KnightHill/wah-hardware/hardware/Terrarium-PedalPCB.pdf

# Terrarium Platform

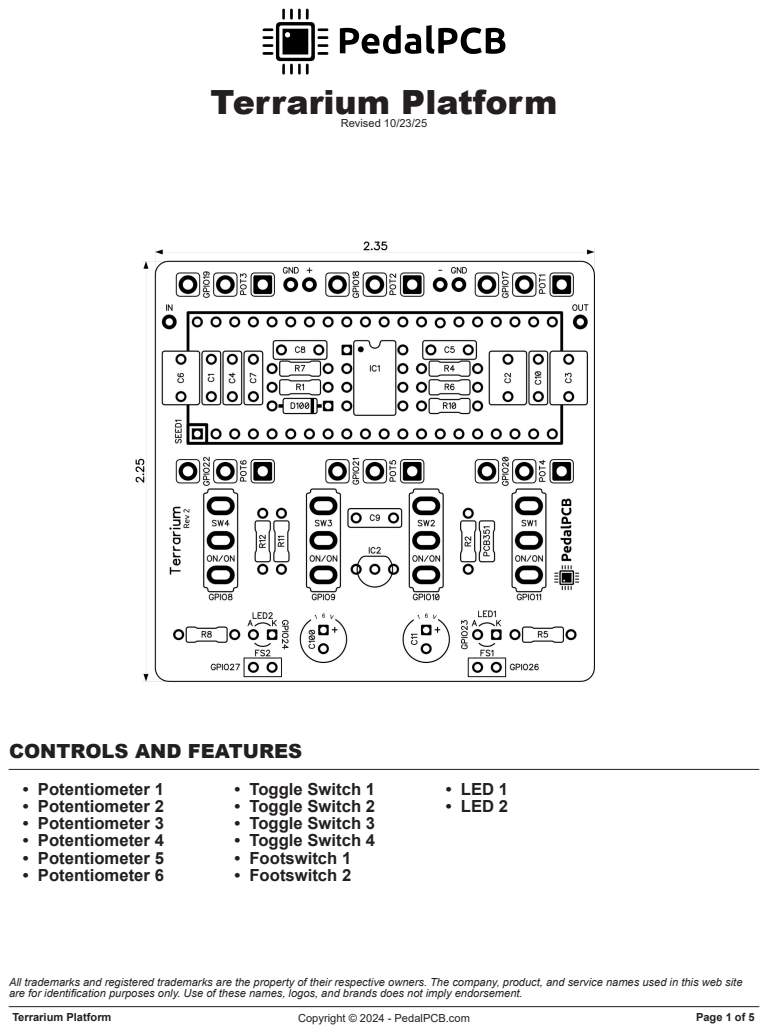
[picture p1: page 1]
Terrarium Platform; Copyright © 2024 - PedalPCB.com; Page 1 of 5; Revised 10/23/25; • Potentiometer 1 • Potentiometer 2 • Potentiometer 3 • Potentiometer 4 • Potentiometer 5 • Potentiometer 6; • Toggle Switch 1 • Toggle Switch 2 • Toggle Switch 3 • Toggle Switch 4 • Footswitch 1 • Footswitch 2; • LED 1 • LED 2

CONTROLS AND FEATURES

All trademarks and registered trademarks are the property of their respective owners. The company, product, and service names used in this web site
are for identification purposes only. Use of these names, logos, and brands does not imply endorsement.

Terrarium Platform | Copyright © 2024 - PedalPCB.com | Page 2 of 5

## Terrarium Platform

Parts List (Page 1 of 1)
LOCATION | VALUE | TYPE | NOTES
R1 | 1M | Resistor, 1/4W
R2 | 1M | Resistor, 1/4W
R4 | 100R | Resistor, 1/4W
R5 | 1K | Resistor, 1/4W
R6 | 100K | Resistor, 1/4W
R7 | 1K | Resistor, 1/4W
R8 | 1K | Resistor, 1/4W
R10 | 3K3 | Resistor, 1/4W
R11 | 100K | Resistor, 1/4W
R12 | 100K | Resistor, 1/4W
C1 | 100p | Ceramic capacitor
C2 | 1u | MLCC capacitor, 7.2 x 2.5mm
C3 | 1u | MLCC capacitor, 7.2 x 2.5mm
C4 | 100n | Film capacitor, 7.2 x 2.5mm
C5 | 100n | Film capacitor, 7.2 x 2.5mm
C6 | 1u | MLCC capacitor, 7.2 x 2.5mm
C7 | 1n | Film capacitor, 7.2 x 2.5mm
C8 | 100n | Film capacitor, 7.2 x 2.5mm
C9 | 100n | Film capacitor, 7.2 x 2.5mm
C10 | 2n2 | Film capacitor, 7.2 x 2.5mm
C11 | 100u | Electrolytic capacitor, 5mm
C100 | 100u | Electrolytic capacitor, 5mm
D100 | 1N5817 | Schottky diode, DO-41
IC1 | TL072 | Dual op-amp, DIP8
IC2 | L78L05 | Linear voltage regulator, 5V
SEED1 | Electro-Smith Daisy Seed Module
POT1 | B10K | 16mm right-angle PCB mount pot
POT2 | B10K | 16mm right-angle PCB mount pot
POT3 | B10K | 16mm right-angle PCB mount pot
POT4 | B10K | 16mm right-angle PCB mount pot
POT5 | B10K | 16mm right-angle PCB mount pot
POT6 | B10K | 16mm right-angle PCB mount pot
SW1 | SPDT ON/ON | Toggle switch, SPDT | 2-position (ON/ON)
SW2 | SPDT ON/ON | Toggle switch, SPDT | 2-position (ON/ON)
SW3 | SPDT ON/ON | Toggle switch, SPDT | 2-position (ON/ON)
SW4 | SPDT ON/ON | Toggle switch, SPDT | 2-position (ON/ON)
FS1 | SPST | Foot switch, SPST | Momentary SPST
FS2 | SPST | Foot switch, SPST | Momentary SPST
PINHEADER | 20-pin Female 2.54mm Pinheader | Quantity: 2

# Terrarium Platform

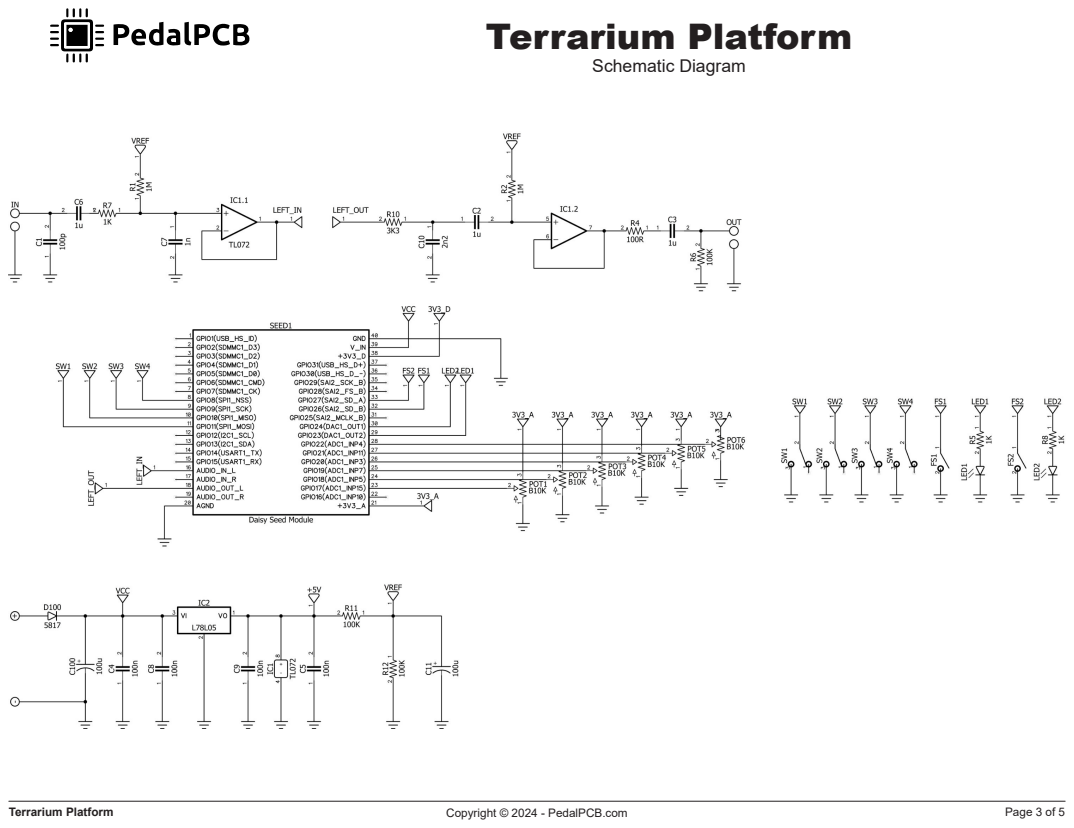
[picture p2: page 3]
Terrarium Platform; Copyright © 2024 - PedalPCB.com; Page 3 of 5; Schematic Diagram

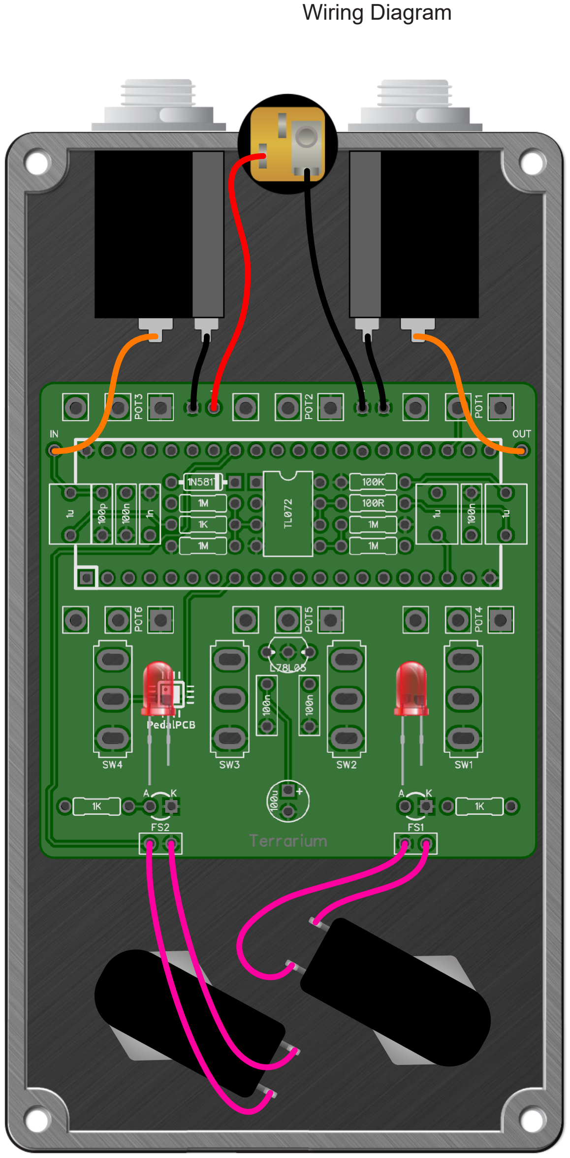
[picture p3: figure]
Wiring Diagram

Terrarium Platform | Copyright © 2024 - PedalPCB.com | Page 4 of 5

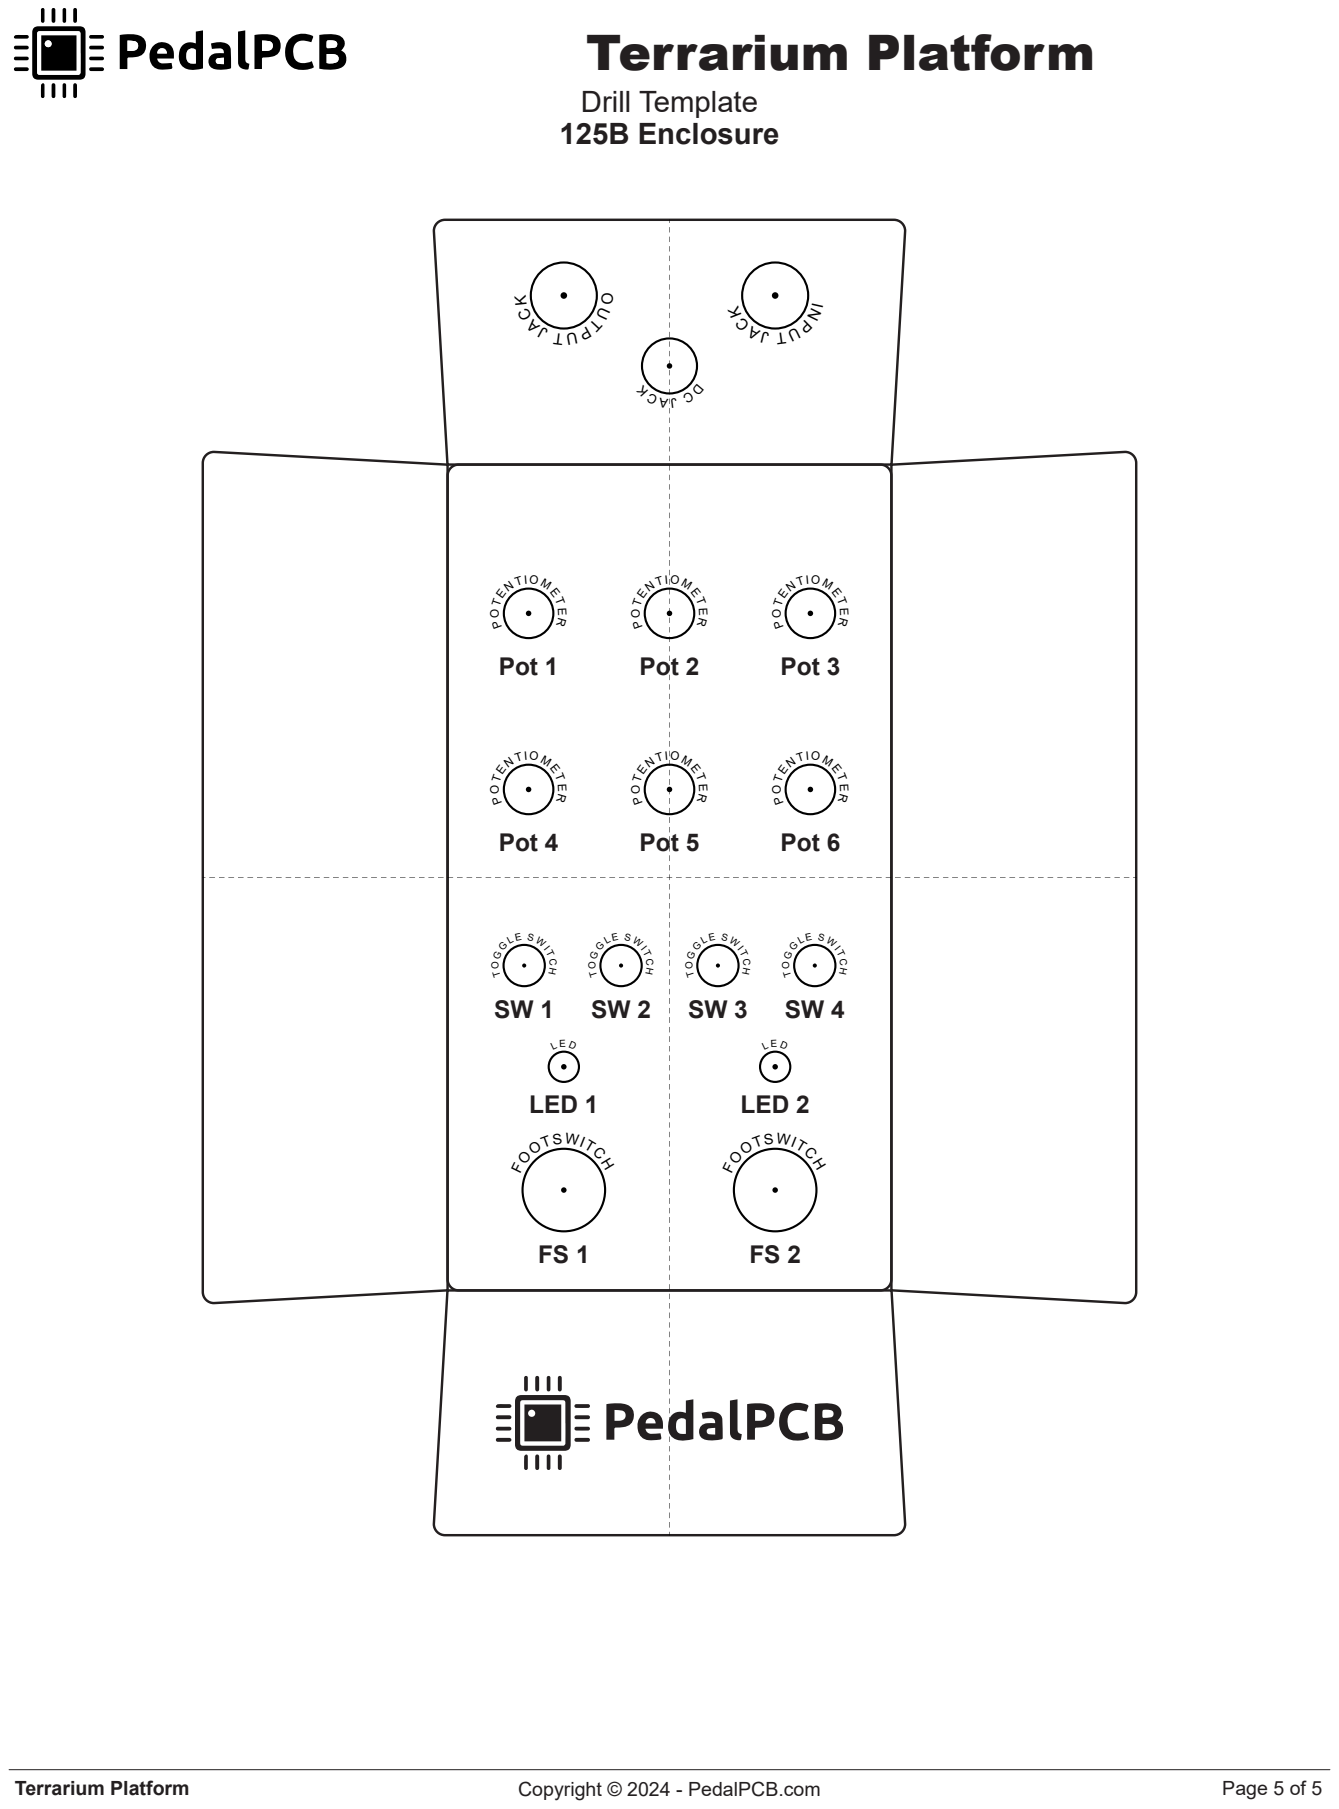
[picture p4: page 5]
Terrarium Platform; Copyright © 2024 - PedalPCB.com; Page 5 of 5; Drill Template 125B Enclosure; Pot 1; Pot 2; Pot 3; Pot 4; Pot 5; LED 1; LED 2; Pot 6; FOOTSWITCH; TENTIO M ET; O UTP; G G LE S WIT
