KnightHill/wah-hardware/hardware/wah.kicad_pcb

## KiCad design hardware/wah.kicad_pcb (2025-10-31)

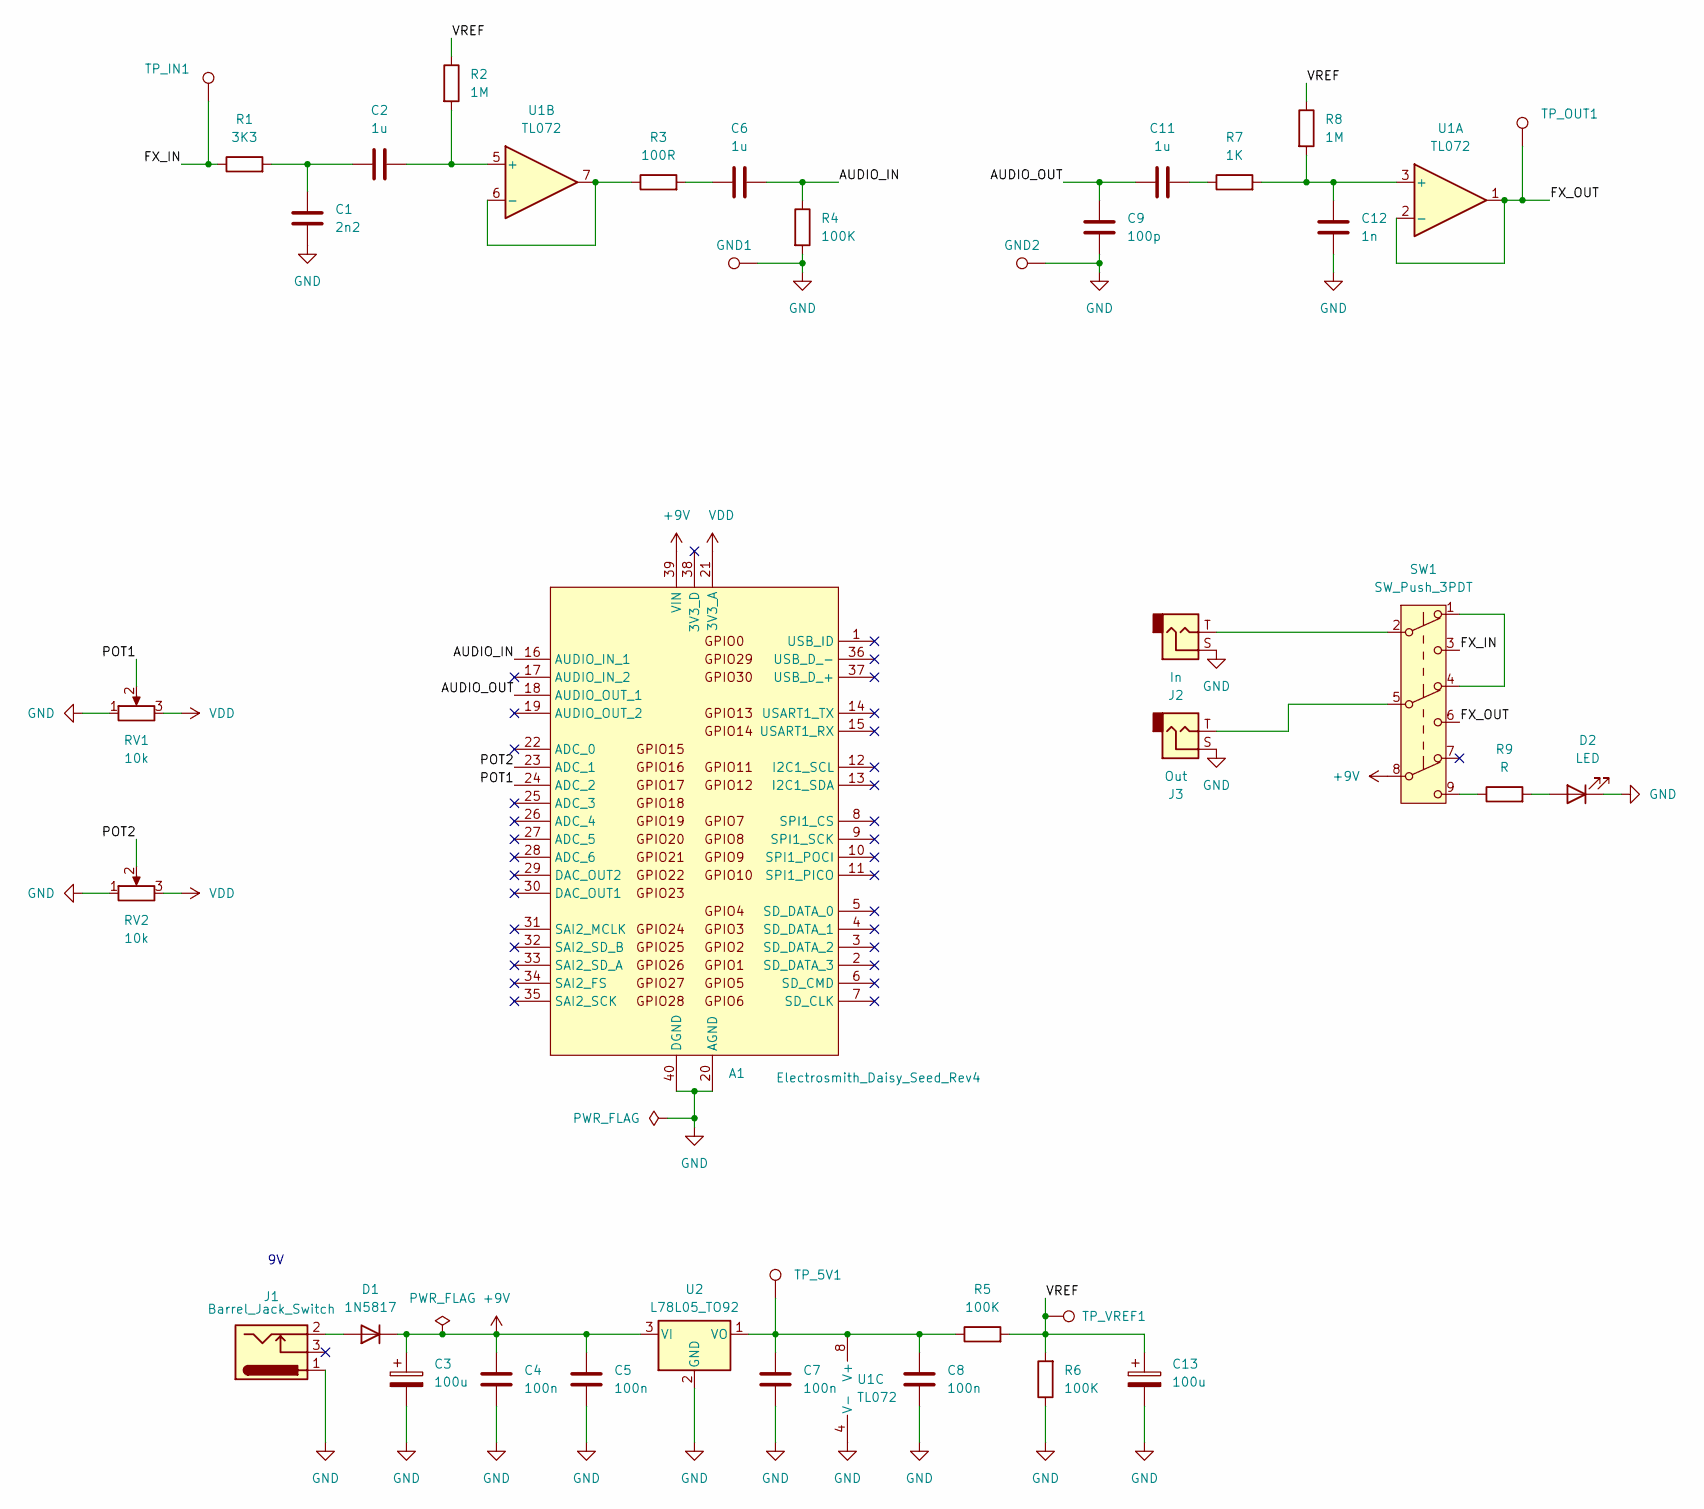
[picture p5: schematic wah.kicad_sch]

Parts:
A1: Electrosmith_Daisy_Seed_Rev4; Electrosmith_Daisy_Seed
C1: 2n2; C_Rect_L7.0mm_W2.5mm_P5.00mm
C2, C6, C11: 1u; C_Rect_L7.0mm_W2.5mm_P5.00mm
C3, C13: 100u; CP_Radial_D6.3mm_P2.50mm
C4, C5, C7, C8: 100n; C_Rect_L7.0mm_W2.5mm_P5.00mm
C9: 100p; C_Rect_L7.0mm_W2.5mm_P5.00mm
C12: 1n; C_Rect_L7.0mm_W2.5mm_P5.00mm
D1: 1N5817; D_A-405_P7.62mm_Horizontal
D2: LED; LED_D5.0mm
GND1, GND2: TestPoint_THTPad_1.5x1.5mm_Drill0.7mm
J1: Barrel_Jack_Switch; Generic_PowerJack
J2: In; Jack_6.35mm_Neutrik_NMJ4HCD2_Horizontal
J3: Out; Jack_6.35mm_Neutrik_NMJ4HCD2_Horizontal
R1: 3K3; R_Axial_DIN0207_L6.3mm_D2.5mm_P7.62mm_Horizontal
R2, R8: 1M; R_Axial_DIN0207_L6.3mm_D2.5mm_P7.62mm_Horizontal
R3: 100R; R_Axial_DIN0207_L6.3mm_D2.5mm_P7.62mm_Horizontal
R4, R5, R6: 100K; R_Axial_DIN0207_L6.3mm_D2.5mm_P7.62mm_Horizontal
R7: 1K; R_Axial_DIN0207_L6.3mm_D2.5mm_P7.62mm_Horizontal
R9: R; R_Axial_DIN0207_L6.3mm_D2.5mm_P7.62mm_Horizontal
RV1, RV2: 10k; Potentiometer_uxcel_9mm_Single_Vertical
SW1: SW_Push_3PDT; Switches_Stomp_Switch_3PDT
TP_5V1: TestPoint; TestPoint_THTPad_1.5x1.5mm_Drill0.7mm
TP_IN1: TestPoint; TestPoint_THTPad_1.5x1.5mm_Drill0.7mm
TP_OUT1: TestPoint; TestPoint_THTPad_1.5x1.5mm_Drill0.7mm
TP_VREF1: TestPoint; TestPoint_THTPad_1.5x1.5mm_Drill0.7mm
U1: TL072; DIP-8_W7.62mm
U2: L78L05_TO92; TO-92_Inline_Wide

Connections:
+9V: A1.39 (VIN), C3.1, C4.1, C5.1, D1.1 (K), SW1.8 (B), U2.3 (VI)
/AUDIO_IN: A1.16 (AUDIO_IN_1), C6.2, R4.1
/AUDIO_OUT: A1.18 (AUDIO_OUT_1), C9.1, C11.1
/FX_IN: R1.1, SW1.3 (C), TP_IN1.1
/FX_OUT: SW1.6 (C), TP_OUT1.1, U1.1, U1.2 (-)
/POT1: A1.24 (ADC_2), RV1.2
/POT2: A1.23 (ADC_1), RV2.2
/VREF: C13.1, R2.1, R5.2, R6.2, R8.1, TP_VREF1.1
GND: A1.20 (AGND), A1.40 (DGND), C1.2, C3.2, C4.2, C5.2, C7.2, C8.2, C9.2, C12.2, C13.2, D2.1 (K), GND1.1, GND2.1, J1.1, J2.S, J3.S, R4.2, R6.1, RV1.1, RV2.1, U1.4 (V-), U2.2 (GND)
unnamed: C1.1, C2.1, R1.2
unnamed: C6.1, R3.2
unnamed: C11.2, R7.1
unnamed: D1.2 (A), J1.2
unnamed: D2.2 (A), R9.2
unnamed: J2.T, SW1.2 (B)
unnamed: J3.T, SW1.5 (B)
unnamed: R9.1, SW1.9 (C)
unnamed: SW1.1 (A), SW1.4 (A)
unnamed: C12.1, R7.2, R8.2, U1.3 (+)
unnamed: C2.2, R2.2, U1.5 (+)
unnamed: R3.1, U1.6 (-), U1.7
unnamed: C7.1, C8.1, R5.1, TP_5V1.1, U1.8 (V+), U2.1 (VO)
VDD: A1.21 (3V3_A), RV1.3, RV2.3

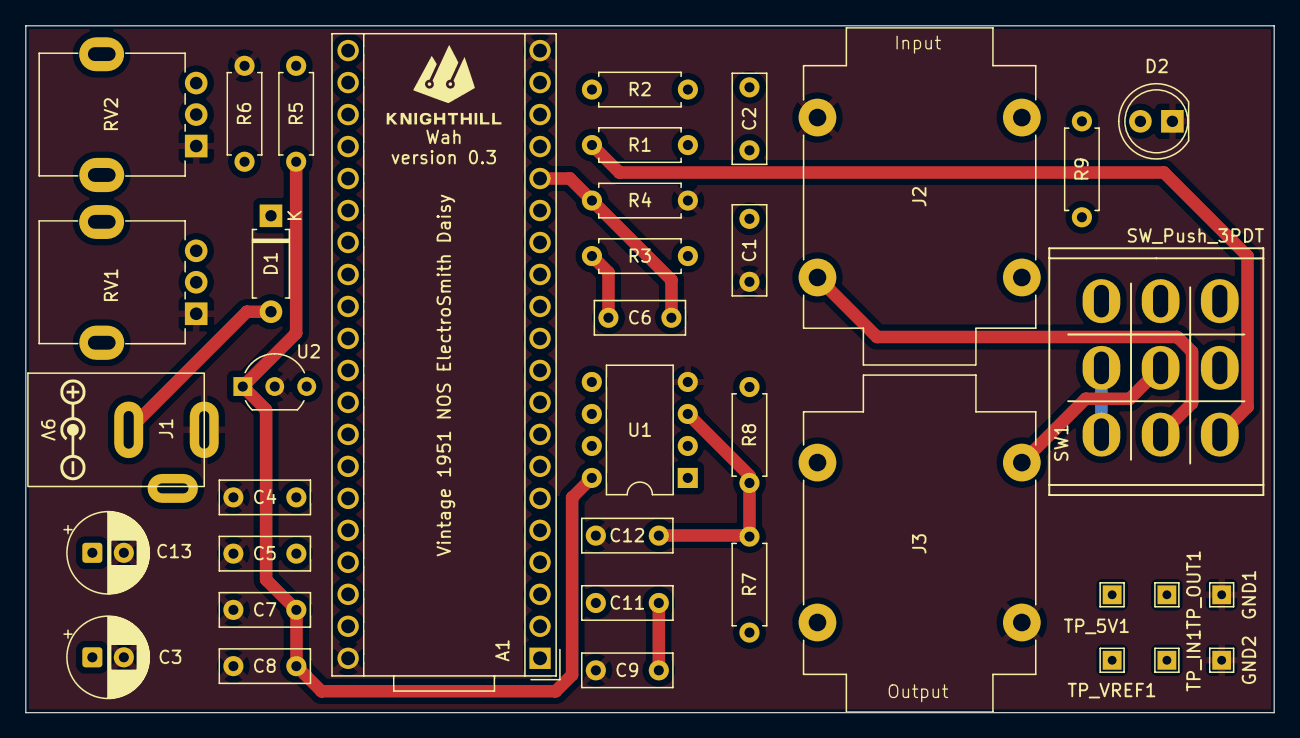
[picture p6: board wah.kicad_pcb from above]

Board: 4 copper layers, 99.1 x 54.5 mm, 38 parts (0 on the bottom side), 23 nets.
