KnightHill/wah-hardware/(commit log)

2025-10-30 improve pcb
    [wah.kicad_pcb, wah.kicad_sch]
2025-10-31 add fab files
    [BOM-wah.csv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]
2025-10-31 fix errors
    [wah-CuBottom.gbr, wah-CuIn1.gbr, wah-CuIn2.gbr, wah-CuTop.gbr, wah-EdgeCuts.gbr, wah-MaskBottom.gbr, wah-MaskTop.gbr, wah-NPTH.drl]
2025-11-13 add test app
    [BOM-wah.csv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]
2025-11-14 fix 2 ADC channels
    [main.cpp]
2025-11-14 add wah filters
